namor5772/GPS/Images/GPSboardA.png

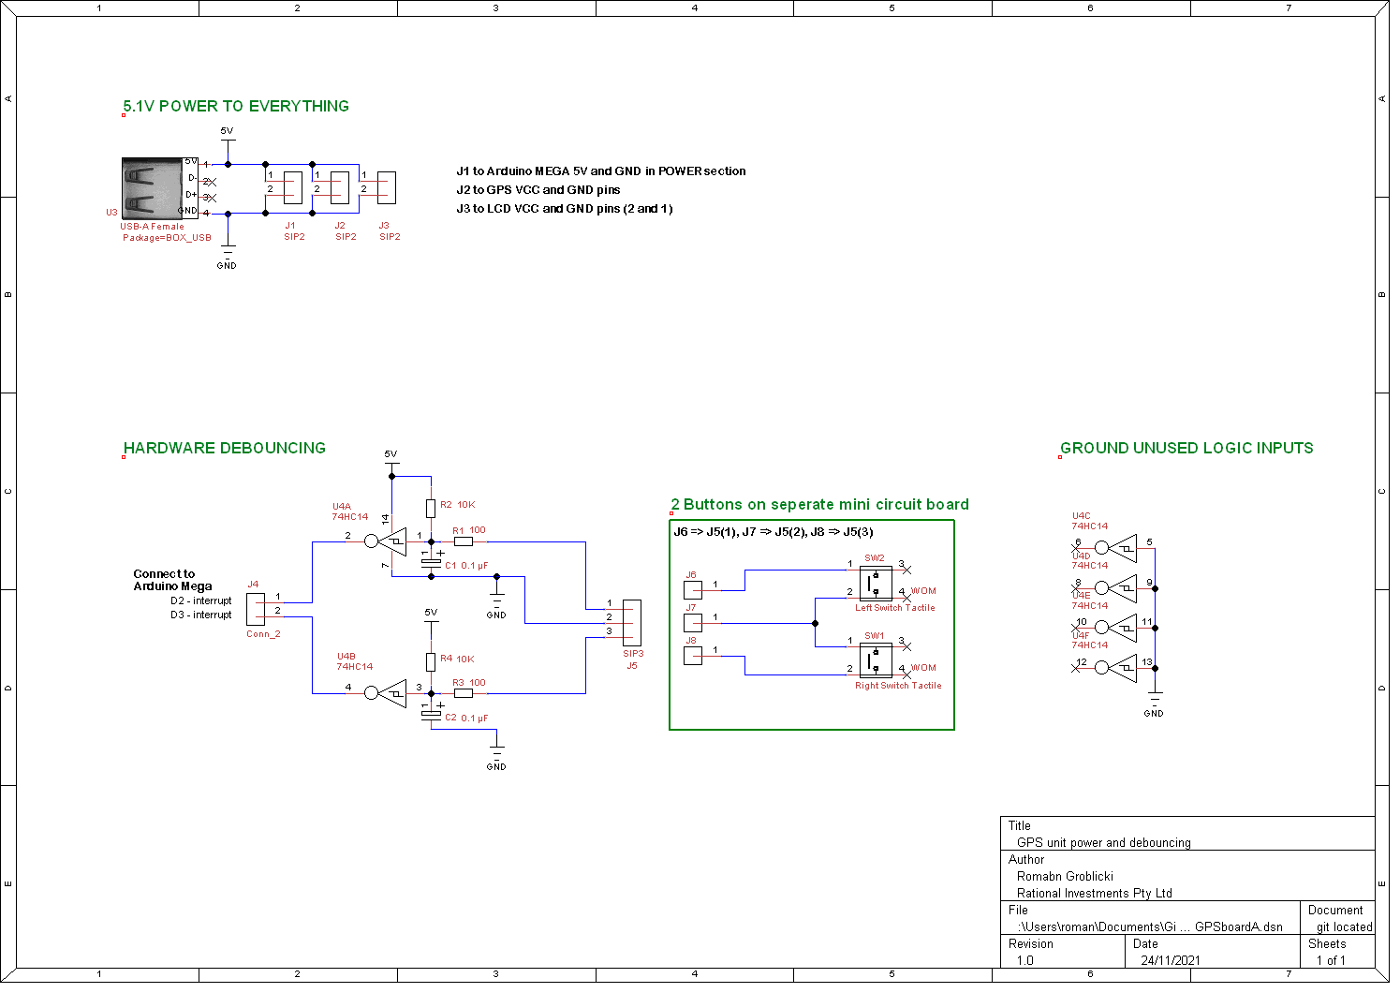
Images/GPSboardA.png
