namor5772/GPS/Images/GPSboardB.png

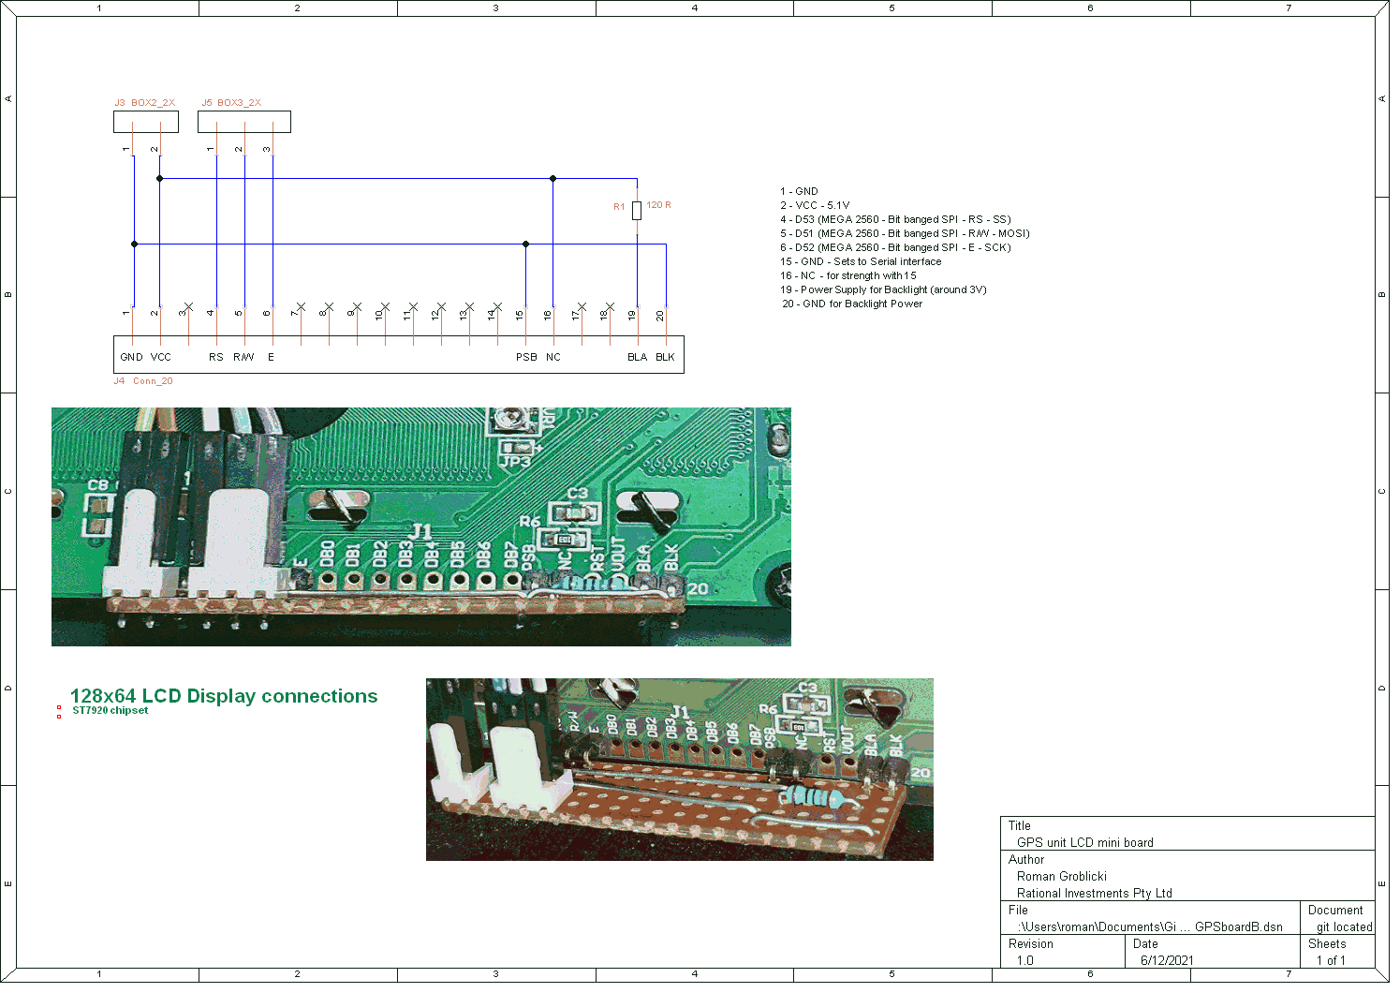
Images/GPSboardB.png
