namor5772/GPS/Images/GPSmodule.jpg

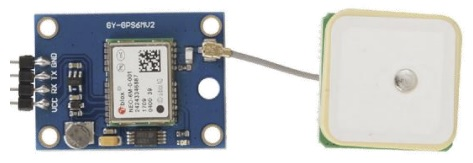
Images/GPSmodule.jpg
