namor5772/GPS/Images/MEGA2560.jpg

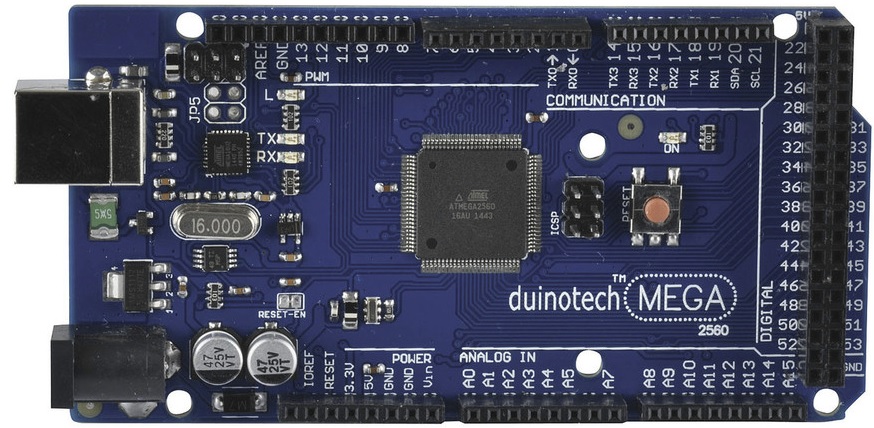
Images/MEGA2560.jpg
