namor5772/GPS/Images/miniboard.jpg

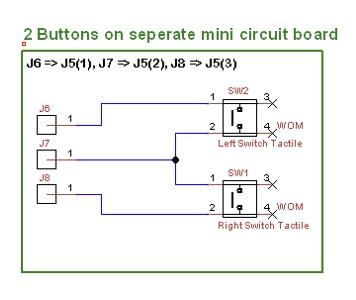
Images/miniboard.jpg
