namor5772/GPS/Images/GPSboardB_components.pdf

Materials : Components. Page 1

Item | Value | Outline ( X, Y)-( X2, X2) Length
J3 | Conn_2 | BOX2_2X ( 5, 20)
J4 | Conn_20 | SIP20 ( 0, 19)
J5 | Conn_3 | BOX3_2X ( 6, 18)
R1 | 120 R | AX3_1 ( 2, 4)-( 2, 1) | 3
