namor5772/GPS/Images/GPSboardA_components.pdf

Materials : Components. Page 1

Item | Value | Outline ( X, Y)-( X2, X2) Length
C1 | 0.1 F | AX2_1 ( 1, 18)-( 1, 13) | 5
C2 | 0.1 F | AX2_1 ( 10, 18)-( 10, 15) | 3
J1 | Conn_2 | SIP2 ( 10, 5)
J2 | Conn_2 | SIP2 ( 9, 5)
J3 | Conn_2 | SIP2 ( 8, 5)
J4 | Conn_2 | BOX2_2X ( 0, 8)
J5 | Conn_3 | SIP3 ( 14, 16)
J6 | Conn_1 | SIP1 ( 4, 26)
J7 | Conn_1 | SIP1 ( 10, 26)
J8 | Conn_1 | SIP1 ( 16, 26)
R1 | 100 | AX2_1 ( 2, 18)-( 2, 16) | 2
R2 | 10K | AX2_1 ( 3, 14)-( 3, 18) | 4
R3 | 100 | AX2_1 ( 9, 18)-( 9, 14) | 4
R4 | 10K | AX2_1 ( 7, 14)-( 7, 18) | 4
SW1Right Switch Tactile | WOM ( 11, 27)
SW2 Left Switch Tactile | WOM ( 5, 27)
U3 | USB-A Female | BOX_USB ( 16, 3)
U4 | 74HC14 | DIP14 ( 7, 7)
