namor5772/GPS/Images/GPSboardB_TinyCad.pdf

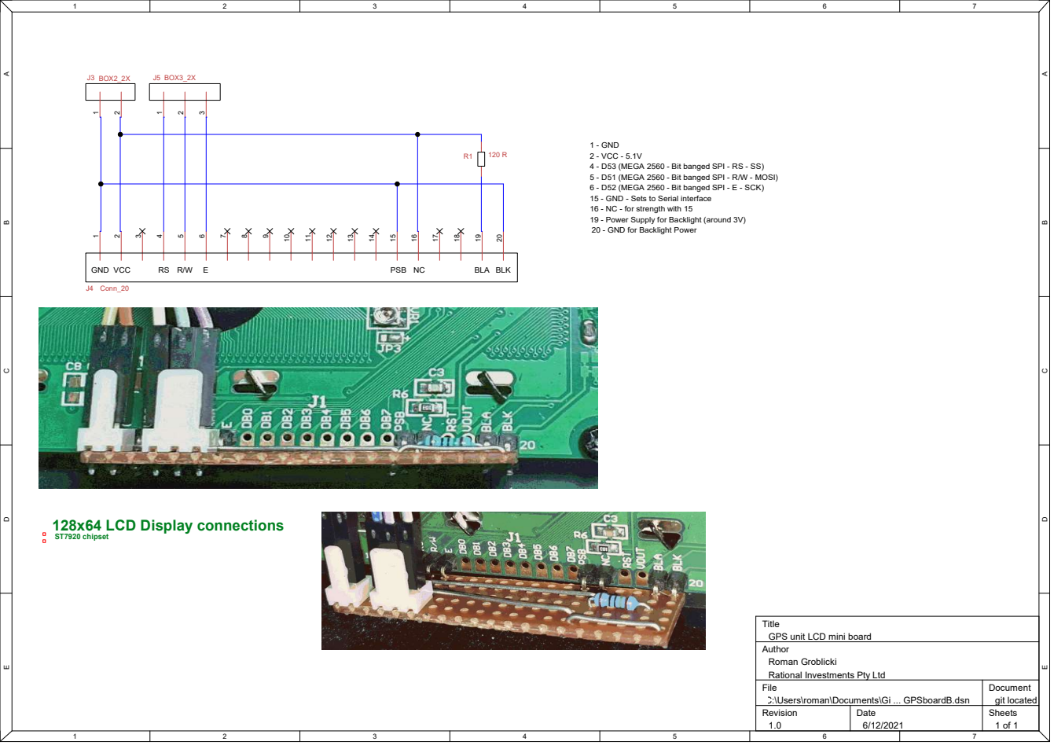
[picture p9: page 1]
128x64 LCD Display connections; J4 Conn_20; 6 - D52 (MEGA 2560 - Bit banged SPI - E - SCK) GND VCC; PSB; BLA BLK; ST7920 chipset; J3 BOX2_2X; J5 BOX3_2X

20 - GND for Backlight Power ¹

1 - GND
2 - VCC - 5.1V
4 - D53 (MEGA 2560 - Bit banged SPI - RS - SS)
5 - D51 (MEGA 2560 - Bit banged SPI - R/W - MOSI)

15 - GND - Sets to Serial interface
16 - NC - for strength with 15
19 - Power Supply for Backlight (around 3V)

Title
GPS unit LCD mini board
Author
Roman Groblicki
Rational Investments Pty Ltd

File C:\Users\roman\Documents\Gi ... GPSboardB.dsn | Document git located

Revision 1.0 | Date 6/12/2021 | Sheets 1 of 1
