namor5772/GPS/Images/GPSboardA_TinyCad.pdf

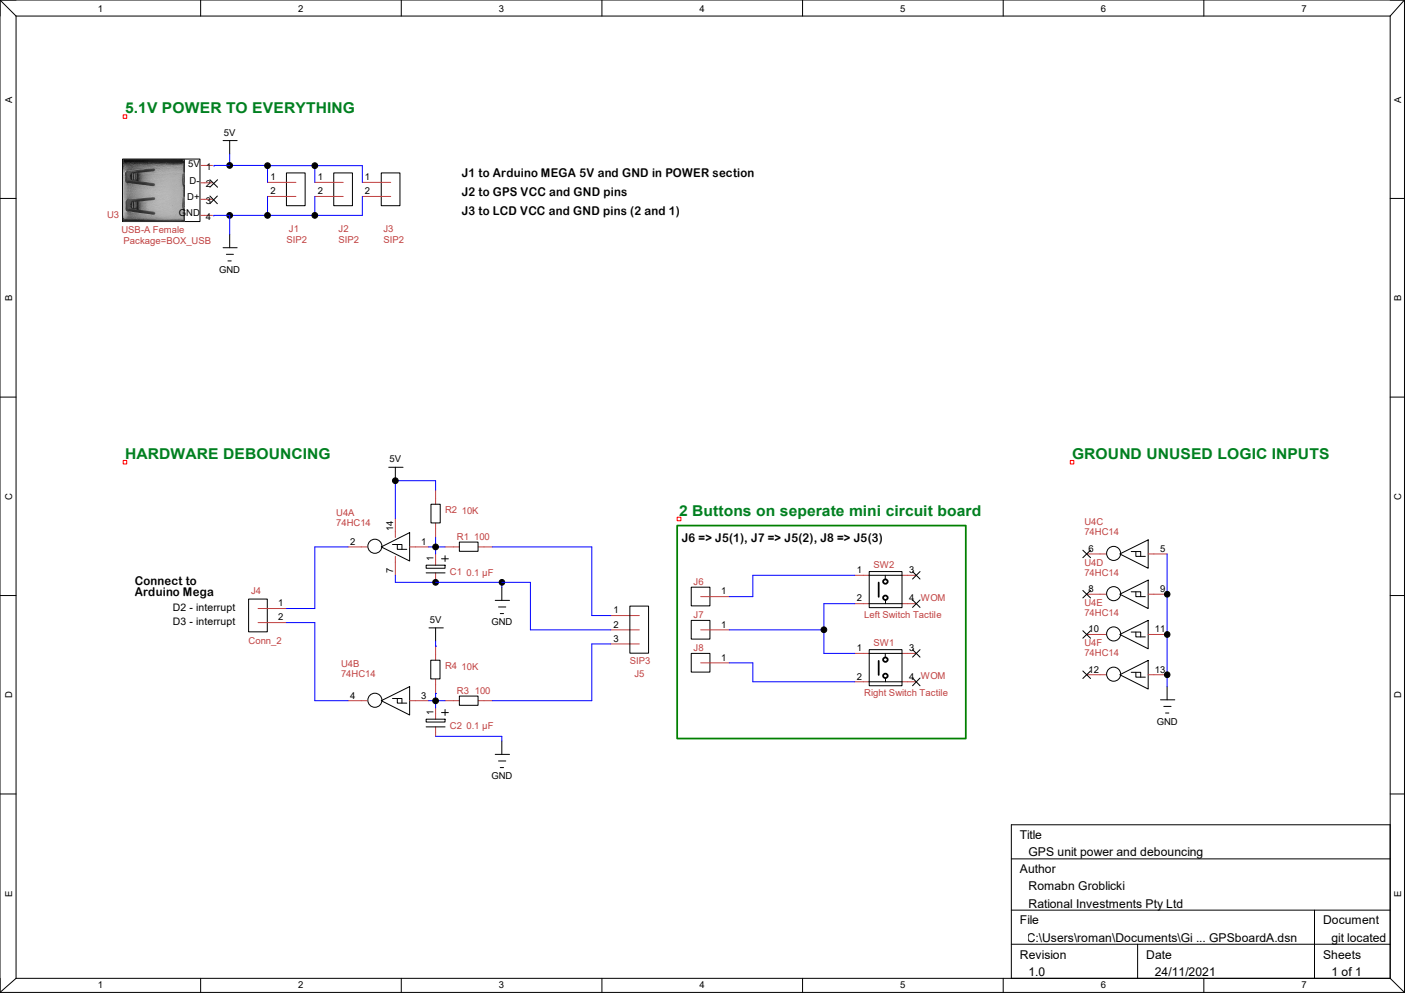
[picture p10: page 1]

J1 to Arduino MEGA 5V and GND in POWER section
J2 to GPS VCC and GND pins
J3 to LCD VCC and GND pins (2 and 1)

J6 2 Buttons on seperate mini circuit board

Title
GPS unit power and debouncing
Author
Romabn Groblicki
Rational Investments Pty Ltd

File C:\Users\roman\Documents\Gi ... GPSboardA.dsn | Document git located

Revision 1.0 | Date 24/11/2021 | Sheets 1 of 1
