namor5772/GPS/Images/GPSboardB.pdf

# J5 J4R1 0123456789

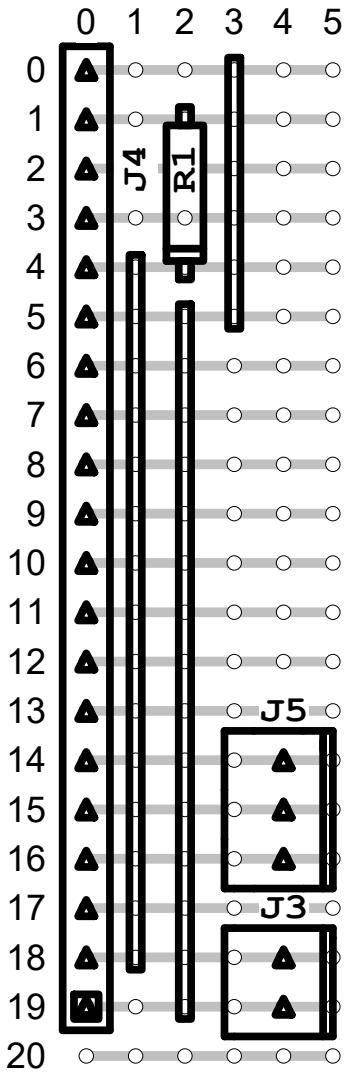
[picture p11: page 1]
