namor5772/GPS/Images/GPSboardA.pdf

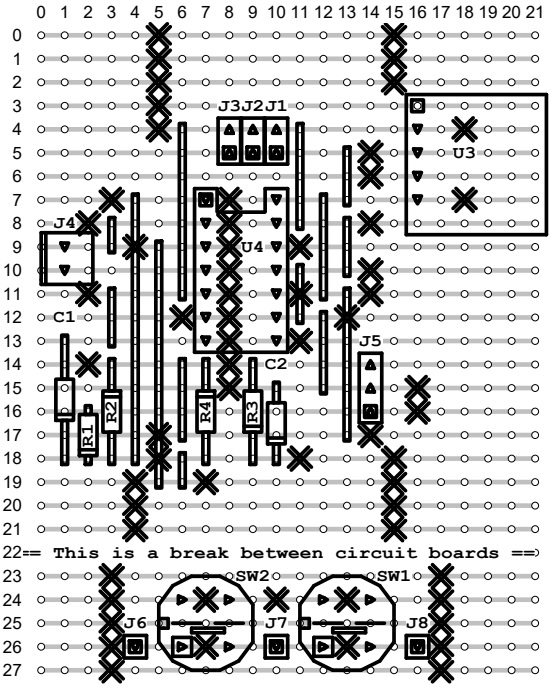
[picture p12: page 1]
