namor5772/GPS/(list of files, drawings)

Other design files:
Hardware/GPSboardB.dsn
