namor5772/GPS/Code/MyST7920/bitmaps.h

// IN GITHUB
// C:\Users\roman\GitHub\GPS\Code\MyST7920

// Various bitmaps used by the LCD

// 16x24 font of {0,..,9,':'} characters in a 176 bit width x 24 bit height array.
// ie. a sequence 32 rows of 22 bytes (= 22byte x8 = 176 bit)
unsigned char SmallerFont [] = {
0x00,0x00,0x00,0x00,0x00,0x00,0x00,0x00,0x00,0x00,0x00,0x00,0x00,0x00,0x00,0x00,
0x00,0x00,0x00,0x00,0x00,0x00,0x00,0x00,0x00,0x00,0x00,0x00,0x00,0x00,0x00,0x00,
0x00,0x00,0x00,0x00,0x00,0x00,0x00,0x00,0x00,0x00,0x00,0x00,0x07,0xE0,0x01,0x80,
0x07,0xC0,0x07,0xC0,0x00,0x70,0x1F,0xF8,0x03,0xF0,0x7F,0xFC,0x07,0xC0,0x07,0xC0,
0x00,0x00,0x0F,0xF8,0x07,0x80,0x1F,0xF0,0x0F,0xF0,0x00,0xF0,0x1F,0xF8,0x0F,0xF8,
0x00,0x0C,0x1F,0xF0,0x1F,0xF0,0x00,0x00,0x1C,0x38,0x0D,0x80,0x38,0x70,0x1C,0x38,
0x00,0xB0,0x18,0x00,0x1E,0x08,0x00,0x18,0x38,0x38,0x38,0x38,0x00,0x00,0x38,0x0C,
0x39,0x80,0x20,0x38,0x10,0x18,0x01,0xB0,0x18,0x00,0x18,0x00,0x00,0x18,0x30,0x18,
0x30,0x18,0x00,0x00,0x30,0x0C,0x21,0x80,0x00,0x18,0x00,0x18,0x03,0x30,0x18,0x00,
0x30,0x00,0x00,0x30,0x30,0x18,0x60,0x18,0x03,0x80,0x70,0x06,0x01,0x80,0x00,0x18,
0x00,0x18,0x03,0x30,0x18,0x00,0x30,0x00,0x00,0x30,0x30,0x18,0x60,0x0C,0x03,0x80,
0x60,0x06,0x01,0x80,0x00,0x18,0x00,0x18,0x06,0x30,0x18,0x00,0x60,0x00,0x00,0x60,
0x18,0x30,0x60,0x0C,0x03,0x80,0x60,0x06,0x01,0x80,0x00,0x18,0x00,0x30,0x04,0x30,
0x1F,0xC0,0x60,0x00,0x00,0x60,0x1E,0x60,0x60,0x0C,0x00,0x00,0x60,0x06,0x01,0x80,
0x00,0x30,0x00,0x70,0x0C,0x30,0x1F,0xF0,0x67,0xE0,0x00,0x60,0x07,0xC0,0x70,0x0C,
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
    0x3e,0x6e,0x60,0xfe,0x66,0x66,0xf7,0x00,// fb01 (uniFB01)
    0x3e,0x66,0x66,0xf6,0x66,0x66,0xf7,0x00,// fb02 (uniFB02)
    0xc3,0x99,0xf9,0xf3,0xe7,0xff,0xe7,0xff,// fffd (uniFFFD)
    0xc3,0x99,0xf9,0xf3,0xe7,0xff,0xe7,0xff   // -001 (.notdef)
};
*/
